ZiadSaoud/Self-Balancing-Robot/Report/Group5_Saoud_Sawaya_Kallas.pdf

## Lebanese American University

MCE 411– Mechatronics System Design II

Instructor: Dr. Noel Maalouf

PROJECT: Self-Balancing Robot.

Ziad Saoud

Roy Sawaya

Chadi Kallas

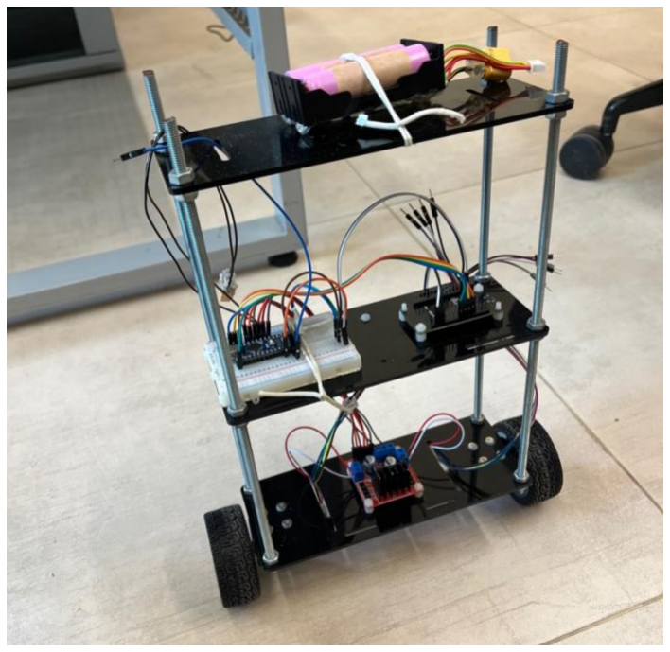
[picture p1: figure]

Date of submission: Saturday, 14 May

### Table of Contents

## System Modeling

Mechanical System:

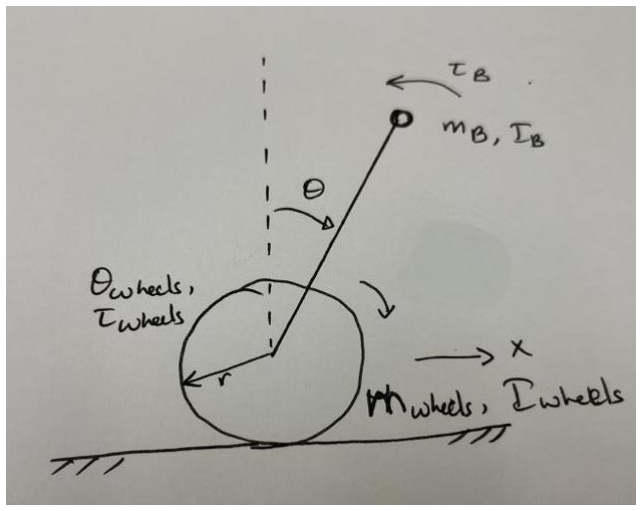
[picture p2: figure]

Figure 1 Free body diagram of the Robot's mechanical System

The no slip condition of movement is given by

x = rθwheel;

The movement of robot’s body COG is given by

xCOG = x + lsinθ

zCOG = lcosθ

vCOG = √ẋCOG + żCOG

Kinetic energy of the body is given by

EkB =

1
2

mbvCOG

2 +

1
2

Ibθ̇Wheels
2 | =

1
2

mb(ẋ + 2ẋlcosθ × θ̇ + l

2θ̇2
) +

1
2

Ibθ2̇

Kinetic energy of the wheel is given by

EkW =

1
2

mWẋ

2 +

1
2

IWheelsθ2 =

1
2

mWẋ

2 +

1
2

IWheels
r

x

2̇

̇

Potential energy of the body is given by

EpB = mbglcosθ

Potential energy of the wheel is given by Epw = 0;

The Lagrangian of the system is defined as the difference between the above kinetic and potential energy:

L = EkB + 2EkW − EpB − 2Epw

The Lagrange second order equations are defined as: d
dt (

δL
δq̇i

) −

δL
δqi = Qi

where qi represents generalized coordinates and Qi represents generalized forces. Generalized forces are torques from both wheels:

Qi = 2τWheels

Position x and angular position θ were chosen as system coordinates Substituting system coordinates into generalized coordinates, we can rewrite the Lagrange second order equations and get equations of motion. For the x coordinate we obtain:

(mB + 2mwheels +

2Iwheels
r

2

) ẍ + mBlcosθ × θ̈ − mBlsinθθ̇2 =

2τWheels
r

and for the θ coordinate the equation is

(mBl

2 + IB)θ̈ − mglsinθ + mBlcosθ × ẍ = 0

Also,

sinθ = θ;

cosθ = 1;

θ̇2 = 0;

The linearized equations become:

(mB + 2mwheels +

2Iwheels
r

2

) ẍ + mBlθ̈ =

2τWheels
r

;

(mBl

2 + IB)θ̈ − mglθ + mBlẍ = 0;

Actuator Subsystem
The brushed DC gearmotors are used as the actuator subsystem of the robot. The subsystem directly provides rotary motion and coupled with the wheels allows the robot to make movement. The input to this subsystem is voltage source Vs applied to the motor’s armature, while the output is the rotational speed ω and torque τW of the gearbox shaft.

The torque τ generated by a DC motor is in general proportional to the armature current i and strength of the magnetic field. Assume that the magnetic field is constant. In that case the motor torque is proportional to the armature current by constant factor kt:

τ = Kt

i;

While the shaft is rotating the back emf voltage Vemf is generated and is proportional to the angular velocity of the shaft by constant factor Ke:

vemf = keω;

From the electrical equivalent circuit of the armature, we can derive the equation:

vs − Ri −

Ldi
dt − vemf = 0;

From the free-body diagram of the rotor we can derive the equation:

IMθM

̈ + bmθM

̇ + τL = τ;

By putting the together, we obtain the equation describing the overall DC motor characteristics

IMθM

̈ + (bm +

KtKe
R

)θM

̇ + τL =

K
R

vs

;

then by using the gear aspect ratio n we obtain:

θM

̇ = nθ̇W ;

τL =

τw
n

;

Substituting the above equations into and denoting by IG the internal inertia of the gear and by bG the internal damping of the gear, we obtain the equation of the actuator subsystem:

(IMn

2 + IG)θ̈W + ((bm +

KtKe
R

)n

2 + bG)θ̇W + τW =

Kn
R

vs

;

Overall Model
DC gearmotors are located between the wheels and the robot’s body.

θWheels − θ = θW

Substituting the equations all together:

(

mbr

2
2

+ mWr

2 + IW + IMn

2 + IG)ẍ+ ((bm +

KtKe
R

)n

2 + bG)ẋ + (mblr

2
/2 −

r(IMn

2 +IG))θ̈ − r((bm +

KtKe
R

)n

2 + bG)θ̇ =

rKtn
R

vs
;

mblẍ+ (mbl

2 + Ib)θ̈ − mbglθ = 0;

The above equations can be rewritten into a matrix form:

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
0/1] [

x
θ
ẋ
θ̇

] + [
0
0
E

−1H

] Vs

## System Control:

To control the tilt angle of our robot we used the MPU6050 sensor it has a built-in accelerometer and gyroscope. It is known that the gyroscope angular velocity readings are not noisy however estimating the tilt angle only using the gyroscope will cause the angle value to drift significantly and on the other side, the accelerometer readings are noisy but do not drift. Hence, we used a dedicated Kalman filter library to use the accelerometer and gyroscope values to get a very good and reliable readings of the tilt angle.

Fuzzy Logic Control
In this part of the report we will show how the fuzzy controller was build and tested on MATLAB before implementing in on hardware.

Construction of Membership functions
To control the system, we first had to get our inputs from the state variable vectors which are: θ
θ̇

For the angle θ (our first input x1
) we decided to choose a universe of discourse of

−π ≤ x1 ≤ π

and for the angular speed θ̇ (second input x2 ) we finally settled for a universe of −10 rad/s ≤ x2 ≤ 10 rad/s

Next for the first input we constructed 3 membership functions each representing the state of the robot at a given time and that can be Positive, Zero, or Negative as shown in figure below:

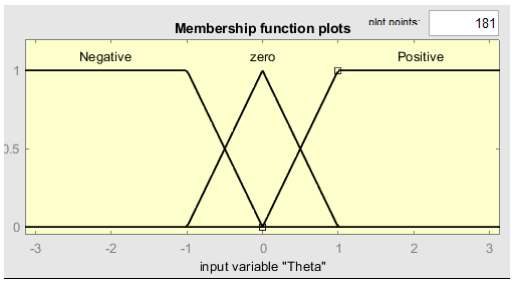
[picture p3: figure]

Then, we construct two membership functions for x2 on its universe, that is, for when the angular speed is either increasing or decreasing: P (positive), N (negative).

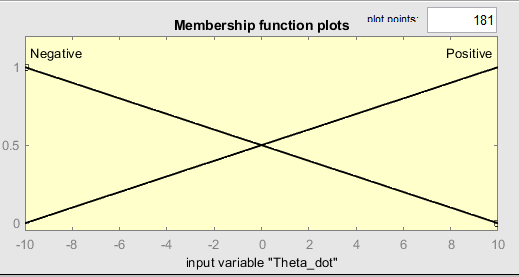
[picture p4: figure]

Finally, to partition our control space output u which is the voltage supplied to DC motors, we constructed five membership function for u on its universe which is

−80V ≤ u ≤ +80V.

The membership functions were divided as follows: NL (negative large), NM (negative), Zero, PM (positive), and PL (positive large).

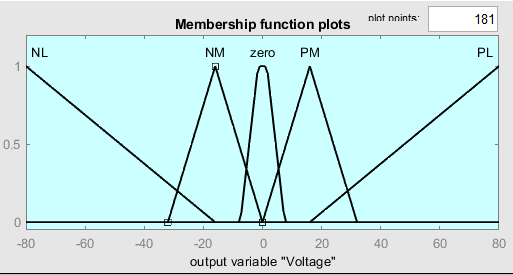
[picture p5: figure]

It is important to note that at the beginning of our simulation we did not have a zero-membership function for our output, however after we added it, we visualized a much better performance of the robot. Additionally, we decided to go one step further and have this membership function as trapezoid ta have a bigger range at 0, this also caused an improvement in the balancing of the robot.

### Constructing the rule base

After the stage of constructing membership functions, we construct a Fuzzy Associative Memory (FAM) Table for the rule base. According to the FAM table our rule base can be expressed as:

R1: if (x1 = N) and (x2 = N) tℎen u = NL

R2: if (x1 = P) and (x2 = P) tℎen u = PL

R3: if (x1 = P) and (x2 = N) tℎen u = NM

R4: if (x1 = N) and (x2 = P) tℎen u = PM

R5: if (x1 = zero) and (x2 = N) tℎen u = zero

R6: if (x1 = zero) and (x2 = P) tℎen u = zero

Additionally, the FAM table for our robot can be seen below:

x2 x1 | Neg | Pos
Neg | NL | PM
Pos | NM | PL
Zero | Zero | Zero

Next, we needed to determine both the fuzzification and defuzzification methods. We opted for both the inference system with Mamdani method, and with the centroid method respectively.

Finally, we did a couple of runs of MATLAB fuzzy to test our fuzzy system and to determine if any change was needed before moving to Simulink

MATLAB implementation and Results

After checking our results on MATLAB fuzzy, we decided to link both our fuzzy controller with our plant that we created earlier.

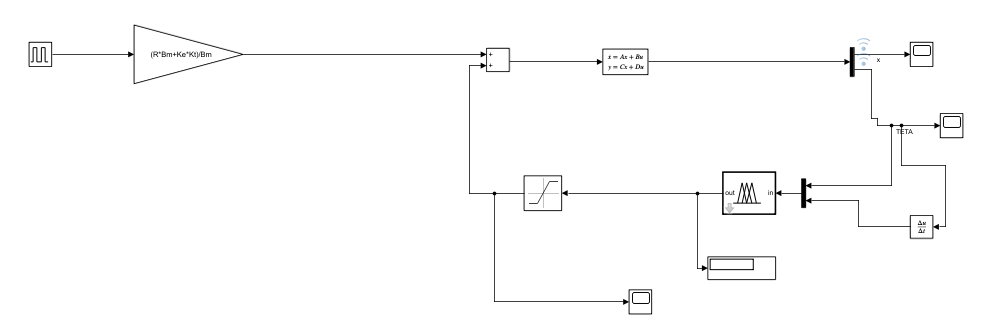
[picture p6: figure]

As shown in the picture above, the output of my system is the state space which will give 4 state variables, however we only needed two to be the input to our fuzzy controller which are θ
θ̇

After both these inputs passes through the fuzzy controller, it will output the voltage V that needs to be fed back to the plant. Moreover, we decided to simulate an external disturbance and this can also be viewed in the image above. This disturbance will be an impulse set by the PWM block that will shock my system every 10sec with a 1% pulse period and with an amplitude of 0.2. The saturation block placed at the output of the fuzzy logic will make sure that the voltage that reached the plant will always be between -12V and 12V.

Additionally, we also wanted to view the change in position and angle of our system so we added a scope to both these variables and after running the system for 10 seconds we observed the following results which can be seen below:

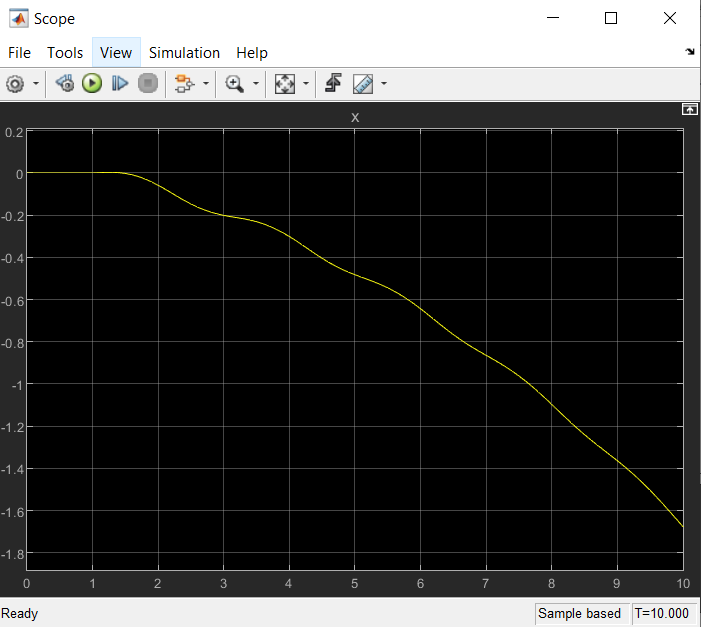
[picture p7: figure]
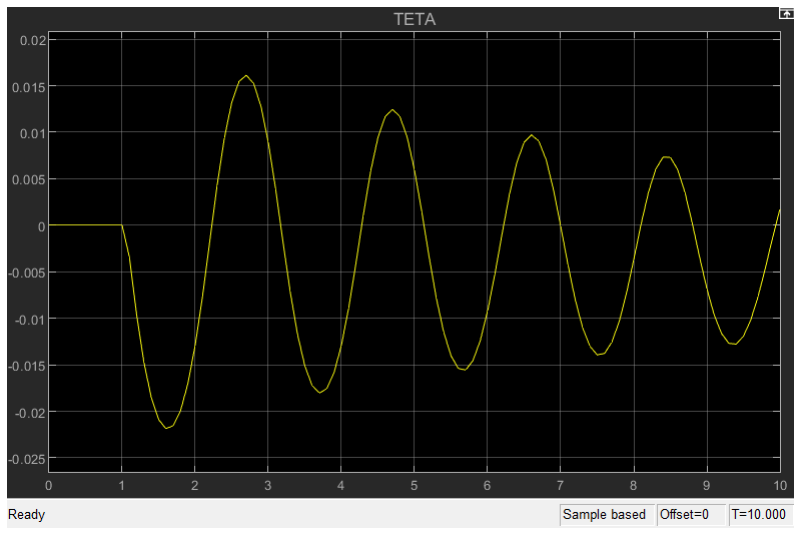
[picture p8: figure]

For the results, we can observe that the angle θ, it is slightly varying between 0.02 rad and -0.02 rad. This actually makes sense since the robot, due to the fuzzy controller will be actively trying to balance itself after being physically pushed (disturbance in the Simulink model). As for the position x, in order to balance itself, the robot will be moving towards the direction where he was pushed to stay balanced. If position control was added then, the position should have oscillated around 0, similar to the angle θ.

We also added a scope to visualize my voltage output that is being fed back to the plant:

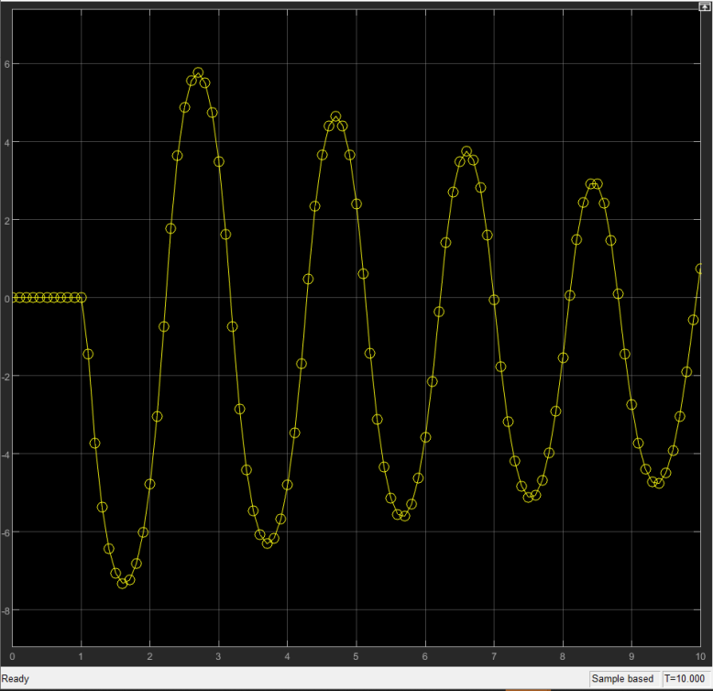
[picture p9: figure]

We can observe that it is following a similar path to the angle θ. This is due to the fact that when θ is at its lowest (robot is falling on the left side), the wheels of the robot need to rotate in the counterclockwise direction to adjust its position, then the voltage supplied to the motors need to be negative and with a high amplitude, and vis versa.

### Wheel synchronizer

After many runs, we realized that the motors did not have the same speed and this affected the performance of the balancing as it can be viewed in the video that we submitted. To fix this issue, we decided to do add a PI controller, which will synchronize both wheels to have the same speed.

The model of the system can be seen below:

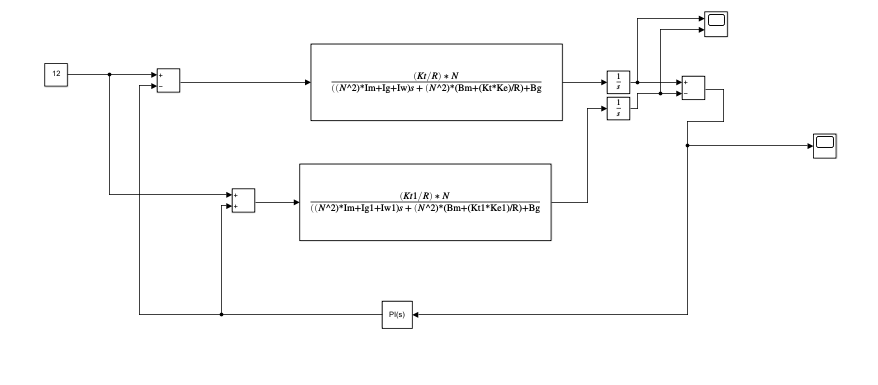
[picture p10: figure]

On MATLAB, to simulate different motor speeds, we changed some parameters of the second motor block, we increased a bit the Kt and Iw parameter and this resulted in a slower output speed. The input of the PI will be the difference of the speed, as it can be considered the error to be fixed. On the other side, the output of the PI will once be added to the reference voltage of 12V for the slower motor, and will be subtracted from the fastest, the it will be respectively fed back to each motor. After auto tuning the PI we got Ki to be 0.225 and Kp to be 0.038.

The results of the scopes can be shown below:

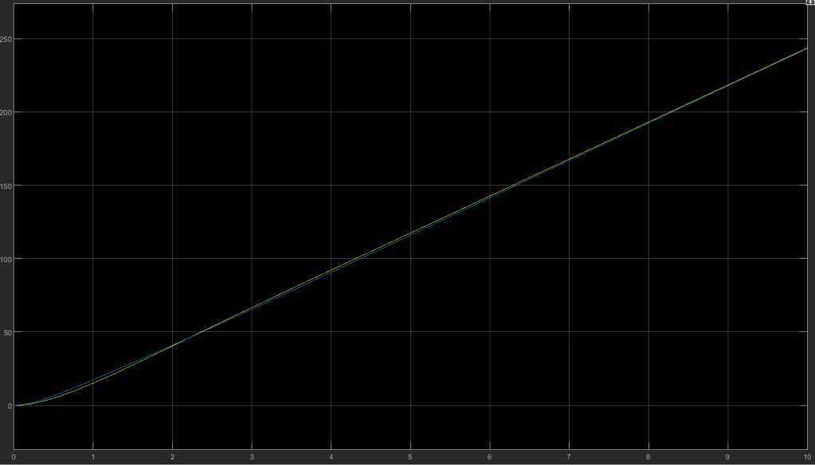
[picture p11: figure]

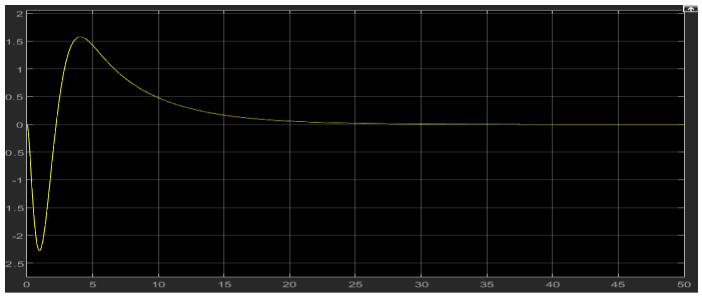
[picture p12: figure]

We can observe that after some time the error between the motors become negligible and the yellow and blue line, which each represent the speed of each motor in the first figure, will follow each other.

However, in the end, due to the limitation of pins and due to time constraint, we decided not to implant this step on the hardware.

## SolidWorks Design

During this project, we had to design the whole robot from the ground up. We first started by getting the exact measurements of DC motor and the wheels. Then we went and designed the first layer whom the motor will be attached to and where the h-bridge will stay. Then we decided that all the batteries and the power bank, which are the heaviest part of the robot, should be place on the top layer so that the robot model will be as close as possible to a pendulum. Finally, a middle layer was created to hold both microcontrollers (the NodeMCU and the Arduino Nano).

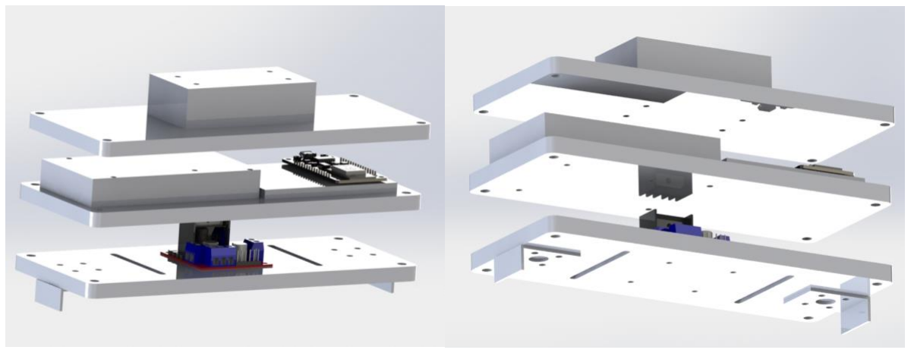
[picture p13: figure]

At the end we opted to carve the three layers using Plexiglas material and not to 3D print them. The Plexiglas material used was 3mm thick and it turned out to be stronger and much cheaper.

## DC Motor Parameter Estimation with MATLAB:

First, we derived the transfer function of the DC motor according to the following image.

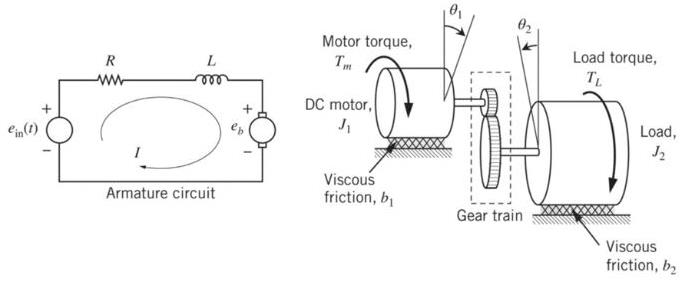
[picture p14: figure]

When performing the parameter estimation experiment our load (Robot wheel) was not touching any surface hence we assumed that the viscous friction is negligible. Also, in the modeling of the motor we neglected the inductance L of the motor. The aim of estimating the parameters where to get a transfer function on MATLAB that behaves as similar as possible to our motor in real life, that will allow us to have a precise model of our robot and will give us a better idea if the control algorithm we are going to implement will actually work or not on real hardware.

Available parameters of the motor:

N: Gears ratio.

Iw: Wheel inertia.

Unknown parameters:

kt: Torque constant.

ke: Back EMF constant.

Im: DC motor rotor inertia.

R: DC motor armature resistance.

bm: DC motor damping coefficient.

bg: DC motor Gearbox damping coefficient

Ig: DC motor Gearbox inertia

### Estimation Experiment:

First, we created a transfer function block of the DC motor on Simulink.

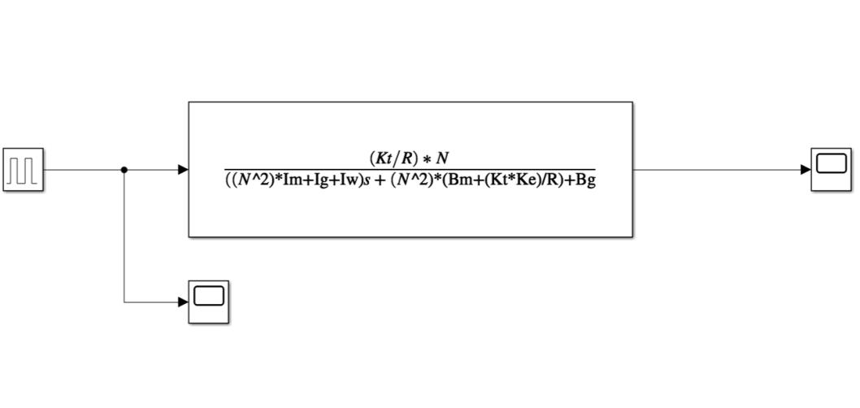
[picture p15: figure]

The input of the block is a voltage and the output is the speed of the motor in rad/s. We apply a voltage pulse on the motor and we measure the speed of the motor in rad/s. In order to collect the speed readings of the motor our motor featured a magnetic quadrature encoder that has a resolution of 11pulses/rotation of the motor shaft. We used the 2 available pins on the Arduino that feature external interrupts to capture the pulses of the encoder, also our program was configured to trigger an interrupt on both rising and falling edges of the two signals A and B of the encoder. In other words, we were using our encoder in X4 resolution mode and therefore we will get a resolution of 44pulses/rotation of the motor shaft. In order to solve for the velocity of the motor our program will get the number of pulses that occurred in a certain time interval and using the following formula to get the velocity.

Wwℎeel =

60 × #Pulses
Resolution × N × Tsampling

(rpm)

After plotting the data of the encoder, we noticed a clear noise in the data and it is caused due to the discrete counts provided by the encoder hence we implemented a digital low pass filter to reduce the magnitude of the noise and hence get a better estimate of the real value of the angular velocity of the wheels.

Low pass filter transfer function:

Wfiltered(s)
W(s)

=

2PIf0
s + 2PIf0

Using the Bilinear Euler Discretization:

Wf(K) =

1
PIf0Ts + 1

(−(PIf0Ts − 1)Wf(k − 1) + PIf0Ts

(W(k) + W(k − 1))

The following picture shows the unfiltered signal in blue and the filtered signal in red.

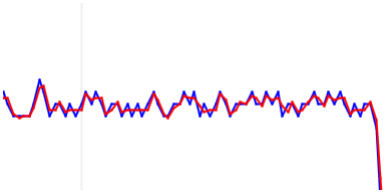
[picture p16: figure]

We tried different variations of the filter with different sampling time and cutoff frequencies and we found best that a cutoff frequency f0 = 15Hz and a sampling Time Ts = 20ms the filtered signal tracks the real signal with minimal delay as seen in the above figure.

Now moving on to the parameter estimation on MATLAB the following picture we can see the collected data from the experiment plotted in Blue and the motor response with initial common known values for the DC motor parameters. We can clearly see the big difference in the response of the real motor and the Simulink block of the transfer function of the motor.

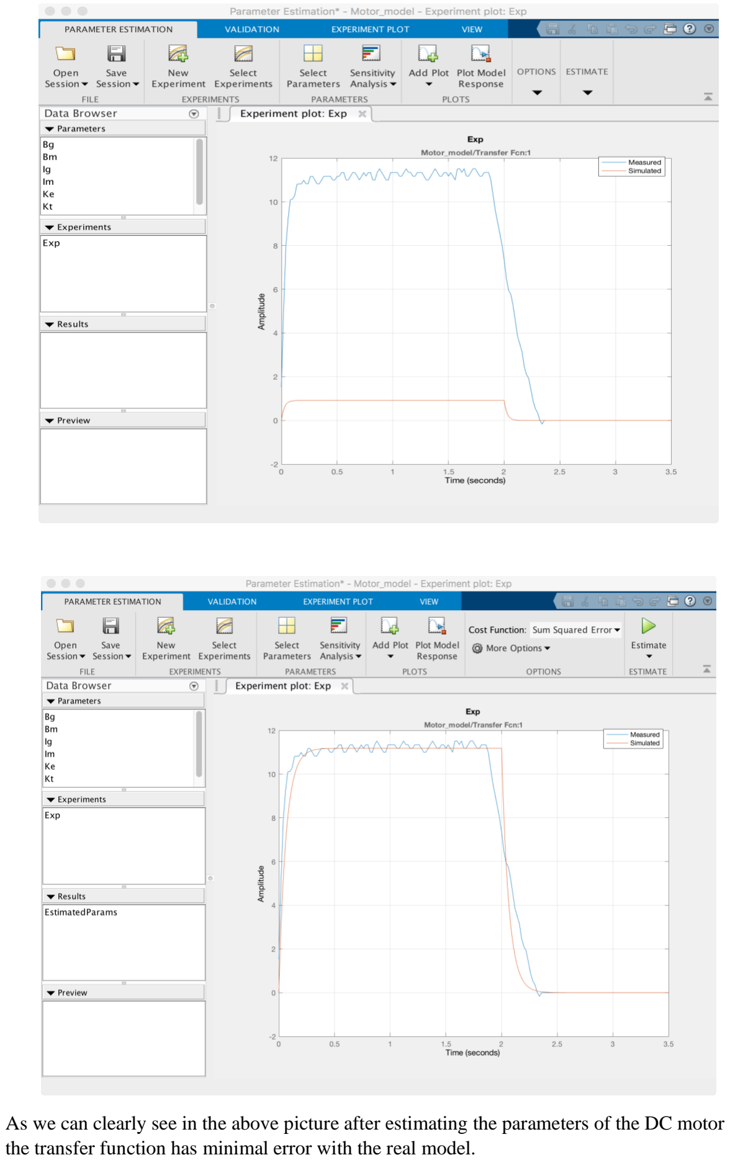
[picture p17: page 16]

As we can clearly see in the above picture after estimating the parameters of the DC motor the transfer function has minimal error with the real model.

## Circuit Design:

For the circuit design our design is simple we had 2 microcontrollers taking over SPI (serial peripheral interface). The ESP8266 microcontroller where the fuzzy controller and Kalman filter are programed it is a fast microcontroller running at 80MHz however it does not feature PWM pins and for PWM generation for controlling the speed and direction of the DC motors we used an Arduino Nano microcontroller that receives the data over SPI from the ESP.

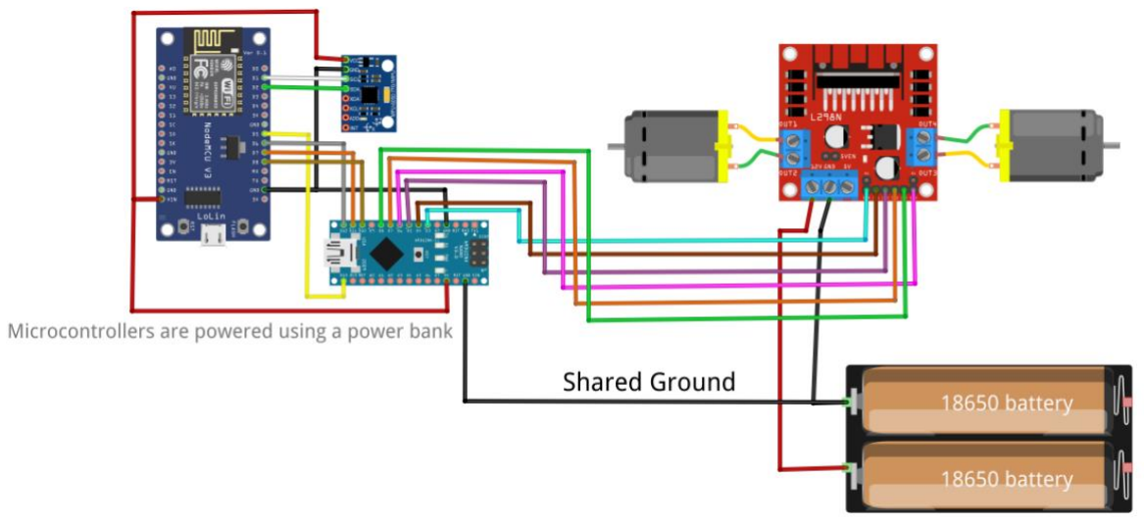
[picture p18: figure]

## Useful Links:

Demo video Link:

https://youtu.be/-Y4fEU-bn3E

GitHub Repository for the project:

https://github.com/ZiadSaoud/Self-Balancing-Robot
